jaibadonak/Joule_Observer34/DECISIONS.md

# Design Decisions

Every real decision gets an entry, written the day we make it. Takes two minutes and saves an argument in October.

The point of this file is the final interview. "Why did you choose X" gets asked, and this is how all four of us give the same answer about something we settled in August.

Anything still `OPEN` past its "needed by" date is a problem worth raising at standup.

---

## Worked example, delete once we have real ones

```
## DECIDED Shunt resistor value
Needed by:  before Lab 3, the differential amp gain depends on it
Owner:      Everyone
Decided:    0.5 ohm, made from two 1 ohm 0805 in parallel
Why:        Max current is 595 mA RMS at 7.5 VA and 12.6 V. Lab 1 caps shunt
            dissipation at 200 mW, and 0.5 ohm gives 177 mW. Splitting it
            across two 0805s puts 88 mW in each, inside the 125 mW package
            rating. Gives 421 mV peak to amplify.
Rejected:   1 ohm, better signal but 287 mW, over the lab limit and over the
            package rating even split two ways. Current transformer, no phase
            error correction needed but bigger, costlier and not in stock.
Date:       31/07/2026
```

---

# Analogue

## OPEN Shunt resistor value
Needed by:  before Lab 3, the differential amp gain depends on it
Owner:      Everyone
Decided:    0.5 ohm, made from two 1 ohm 0805 in parallel
Why:        Max current is 595 mA RMS at 7.5 VA and 12.6 V. Lab 1 caps shunt
            dissipation at 200 mW, and 0.5 ohm gives 177 mW. Splitting it
            across two 0805s puts 88 mW in each, inside the 125 mW package
            rating. Gives 421 mV peak to amplify.
Rejected:   1 ohm, better signal but 287 mW, over the lab limit and over the
            package rating even split two ways. Current transformer, no phase
            error correction needed but bigger, costlier and not in stock.
Date:       31/07/2026

## OPEN Voltage divider values
Needed by: week 4. Lab 1 Q4.1 targets 2 Vpk-pk at 15.4 Vrms.
Owner:

## OPEN Op-amp choice
Needed by: week 3. LT6221 confirmed usable for SMT pending stock. Rail to rail
but a dual not a quad, and higher supply current than the LM324. Option to mix.
Owner:

## OPEN Offset voltage
Needed by: week 4. Depends on the op-amp choice. 2.1 V is the as-taught answer
from LM324 headroom. Rail to rail lets us re-centre and use more ADC range.
Owner:

## OPEN ADC reference
Needed by: week 4. AVCC as taught, or an external LM4040. Only worth doing
together with the offset decision. Check the emulator amplitude first.
Owner:

## OPEN Anti-alias filter corner
Needed by: week 4. Lab says below 5 kHz. Alternating channels through one mux
makes the real per-channel Nyquist 2.4 kHz. Worth asking a TA.
Owner:

## OPEN First or second order filter
Needed by: before the analogue freeze, 1 Sep
Owner:

## OPEN Regulator: how the voltage drop gets shared
Needed by: week 4. Rin vs regulator dissipation, and whether the 78L05 survives
whatever current we end up drawing.
Owner:

## OPEN Zero-cross detector circuit
Needed by: before the analogue freeze. This is the one block the course leaves
entirely to us, so expect it to be probed hardest.
Owner:

# Firmware

## DECIDED Replace external mode LEDs with display suffixes
Needed by:  local display integration
Owner:      Team 34
Decided:    Remove ESP32 indicator GPIO setup/writes. Use the AVR's right-most
            digit (DS1) for U/A/P/E, leaving three digits for V/A/W/Wh.
            Adjust decimals automatically; UART current stays in mA and mode
            packets remain available as website metadata.
Why:        User requested a letter on the existing display instead of wiring
            four GPIO-driven LEDs. U is legible on seven segments; A uses amps
            so 400 mA is correctly labelled 0.40A.
Rejected:   Showing 400A for a 400 mA load; losing the suffix on overflow.
Date:       18/10/2026

## DECIDED Scope telemetry and calibration header
Needed by:  dashboard integration and scope comparison
Owner:      Team 34
Decided:    Send 32 contiguous V/I sample pairs at 104 us per point, AVR energy
            totals, and full-block raw ADC statistics over UART. Keep reference
            and channel gains in calibration.h, generated by the dashboard or
            edited directly. Rebuild/reflash AVR to apply; derive power scaling
            from both gains. Serve deterministic gzip HTML from ESP32 flash.
Why:        Actual captures expose distortion and flat/clipped channels. Raw
            RMS, DC and peak-to-peak support scope comparison without assuming
            a sine. One header avoids inconsistent power and waveform gains.
Rejected:   Synthetic live waveforms; gain calibration on a flat/clipped input;
            remote AVR writes without a receiver/bootloader protocol.
Date:       18/10/2026

## DECIDED Display digit order verified on hardware
Needed by:  display integration
Owner:      Team 34
Decided:    DS1 is the right-most digit, DS4 is the left-most. Scan logical
            least-significant digit first using DS1, DS2, DS3, DS4.
Why:        Bench readings were reversed: 400 appeared as 004 and 13.70 as
            073.1. Reversing digit enables also places the decimal correctly.
Rejected:   Reversing numeric strings or moving decimal bits separately.
Date:       18/10/2026

## DECIDED Single AVR project and ESP32 display indicators
Needed by:  hardware triage and final integration
Owner:      Team 34
Decided:    Retain the newer RMS-current implementation as
            Software/Joule_observer/Joule_observer.atsln (ATmega328PB, 2 MHz).
            Remove the duplicate Testing and placeholder UART AVR projects.
            USART0 sends $D,0..3 on display changes and every 250 ms.
            ESP32 LED1/2/3/4 use GPIO25/26/27/32 for V/I/P/E respectively.
            Keep UART2 RX on GPIO16; the schematic's RXD0 label was incorrect.
Why:        User requested one AVR project and mode LEDs driven by ESP32.
            The retained implementation removes each ADC channel's DC offset.
            Explicit mode messages follow the AVR scan instead of a second timer.
Rejected:   Independent ESP32 mode cycling, which drifts or resets out of sync.
Date:       18/10/2026

## OPEN Clock source
Needed by: week 3. Crystal or internal RC. Affects baud margin and the energy
time base.
Owner:

## OPEN Fixed point format
Needed by: week 4. Show the worst case headroom at 7.5 VA.
Owner:

## OPEN Sampling scheme and skew correction
Needed by: week 7. Channel order, how we realign, and how we handle the
residual.
Owner:

## OPEN How the display gets clocked
Needed by: week 3. Hardware SPI or bit bang, given USART1 overlaps SPI0 and the
ISP pins.
Owner:

## OPEN Programming interface
Needed by: week 3. ISP only or debugWIRE too. Constrains what hangs off RESET.
Owner:

# Board

## OPEN USB to serial bridge part
Needed by: week 3
Owner:

## OPEN BLE or WiFi
Needed by: week 3. Drives the power budget.
Owner:

## OPEN Altium workspace or local files
Needed by: week 3, before library work starts. Four of us drawing footprints
into files that cannot be merged is the thing to avoid.
Owner:

## OPEN Enclosure approach
Needed by: week 8
Owner:

# Project

## OPEN Are we doing the Smart Energy Challenge
Needed by: week 6, needs the course director's permission
Owner:
