jaibadonak/Joule_Observer34/L6 - Opamps.pdf

# ELECTENG 209

# Electronics System Design

## Signal Conditioning

Grant Covic and Duleepa Thrimawithana

# Learning Objectives

- Review of operational amplifier basics
- What are inverting and non-inverting amplifiers
- How are difference amplifiers created and why are they useful?
- Understanding practical signal conditioning circuits using single sided supplies
- What practical considerations are needed with voltage and current measurement circuits?
- How do we create RC filters and what are the design approaches in the frequency domain?
- Understanding the use and design of comparators for interrupt circuits
- Design guidelines for creating a regulated supply suited to your analogue and digital electronics.
Grant Covic and Duleepa Thrimawithana, Department of Electrical, Computer, and Software Engineering (2022) | 2

# The Energy Monitor Hardware design

- Requires Voltage Sensing, Current Sensing as discussed earlier.
- Signal conditioning
- Level shifting, amplification and noise reduction
- Generation of a suitable interrupt to trigger measurement from the microprocessor.
- Practical operation from a single 5V power regulator.

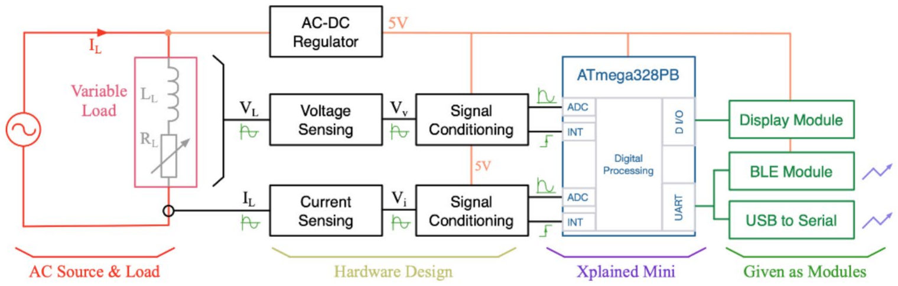
[picture p27: figure]

Grant Covic and Duleepa Thrimawithana, Department of Electrical, Computer, and Software Engineering (2022)

# Op-Amp Signal Conditioning

# Review of op-amps The inverting op-amp The non-inverting op-amp The difference amplifier Operation from a single sided supply Practical considerations with sensing voltage or current

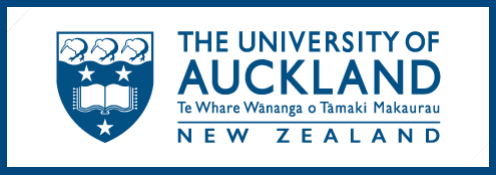
[picture p28: figure]

# The Op-Amp Equivalent Circuit

The op-amp equivalent circuit is shown in the figure below:

- Ideally RRiiii = ∞, rroo = 0, and the internal gain μμ = AA = ∞
- Input voltages vv1 and vv2 are independent
- The output voltage vvoo is ideally the amplification of vviiii = vv(+) − vv − , the voltage difference at the input terminals

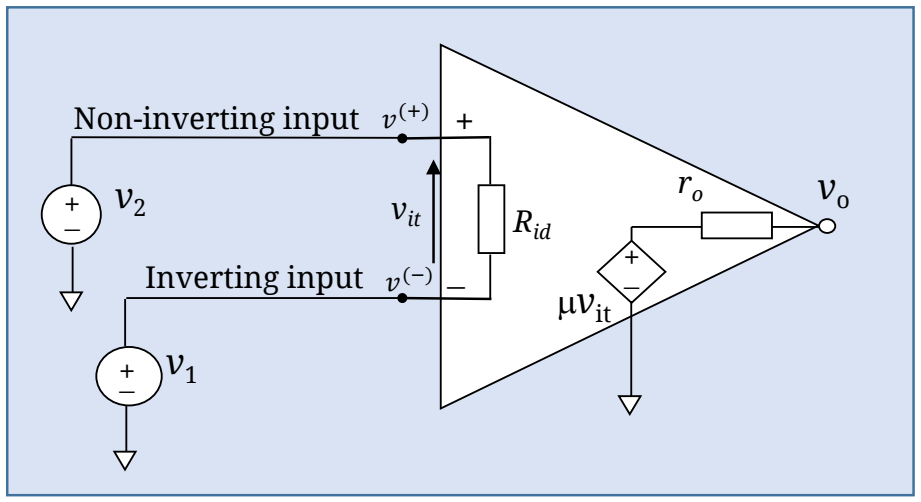
[picture p29: figure]
vit; µvit; Rid; Non-inverting input; Inverting input

# Virtual Earth Principle?

- In operation the output voltage is limited by the DC supplies of the op-amp.
- If the gain of the operational amplifier is very large the input terminals are kept at the same potential. This is a virtual short-circuit. Expressing this mathematically:

If AA = ∞, then the input voltage across the two terminals: vviiii = vv(+) − vv(−) = vvoo⁄AA = 0VV
- If the vv(+)

terminal is “grounded” to 0V , then this means the negative terminal vv(−) is a virtual earth.

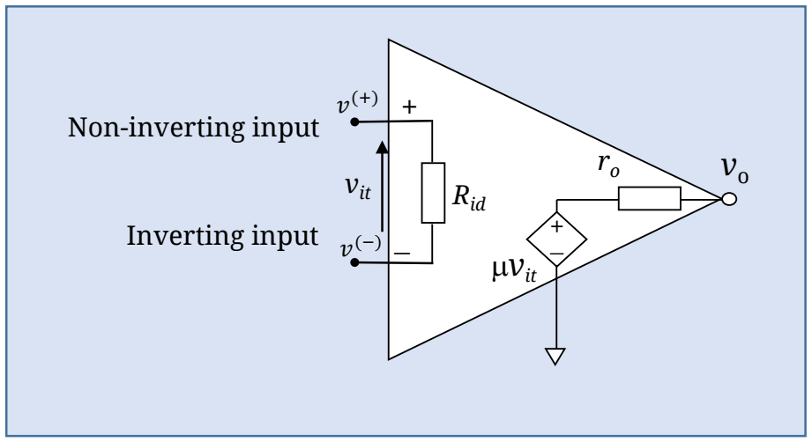
[picture p30: figure]
vo vit; µvit; Rid; Non-inverting input; Inverting input

# The Inverting Operational Amplifier

A circuit can be created with a single voltage input vvii and resistors RR1and RR2 around this op-amp as shown below.
- By grounding the positive input vv(+) = 0, because of the virtual earth (short circuit at the input) effectively vv(−) = 0
- To determine the gain, use Ohm’s and Kirchhoff’s voltage and current laws.

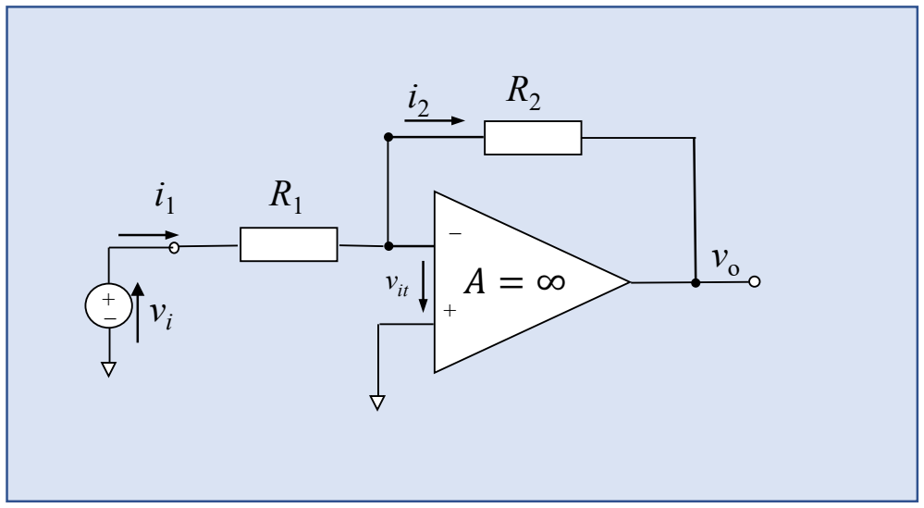
[picture p31: figure]
vit

# The Inverting Operational Amplifier

- A current ii1will flow because of input vvii
- Using Ohms law, given vv − = 0 by virtual earth:

# ii1 = vi − v ⁄ (−) RR1 = vi⁄RR1 ii2 = v ⁄ − − vo RR2 = −vo⁄RR2

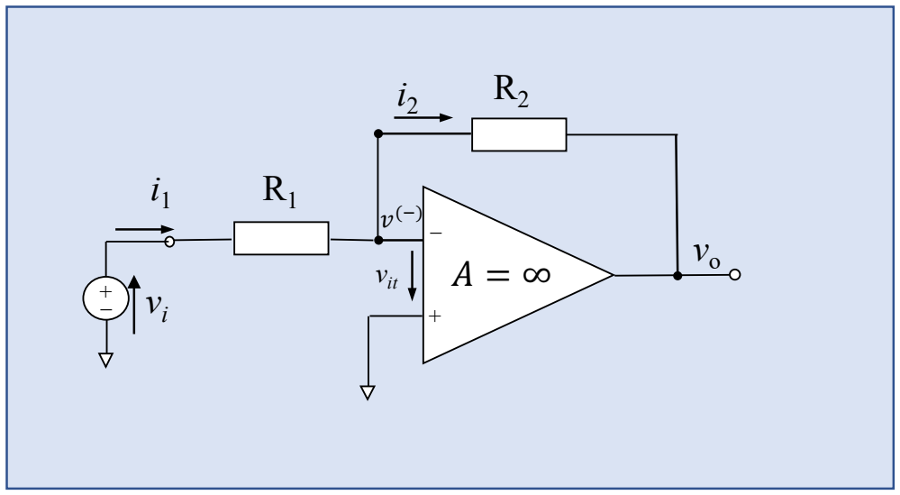
[picture p32: figure]
vit

# The Inverting Operational Amplifier

- Using Kirchhoff’s current law at a node ∑ ii = 0, evaluate the negative input terminal node
- Since ideally RRiiii = ∞ then no current will flow into the op-amp so: ii1 = ii2 ⇒
vvii
RR1

# = −vvoo

RR2
- Rearrange for the circuit voltage gain: GG = vvoo

vvii

= −RR2
RR1

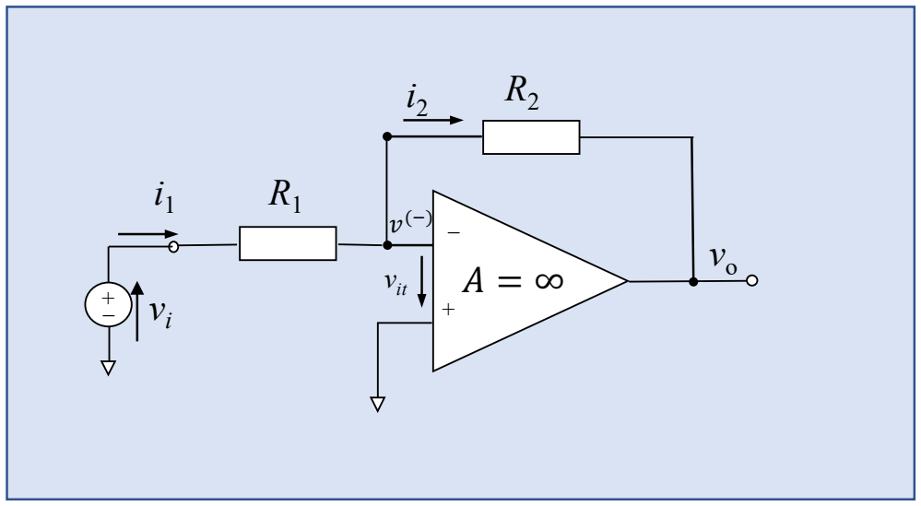
[picture p33: figure]
vit

# The Non-inverting Operational Amplifier

If the input is shifted to the positive terminal then a non-inverting configuration can be created as shown below:

- Following a similar analysis, with ideal infinite gain then vviiii = vv(+) − vv(−) = vvoo⁄AA = vvoo⁄∞ = 0

# - Then vv(−) = vv(+) = vvii

- Solve for the circuit gain again using Ohm’s and Kirchhoff’s laws.

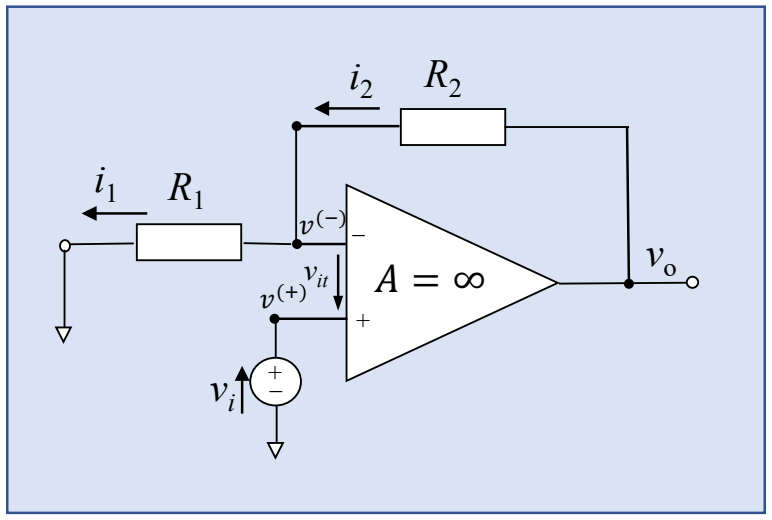
[picture p34: figure]
vit

# The Non-inverting Operational Amplifier

- Again the current into the op-amp at the negative terminal is zero because RRiiii = ∞
- So given ∑ ii = 0 then ii2 = ii1, where:

# ii1 = vv ⁄ (−) RR1 = VVii⁄RR1 ii2 = vv0 − vv ⁄ (−) RR2

- Equating the currents and rearranging for the voltage gain gives: GG ≡

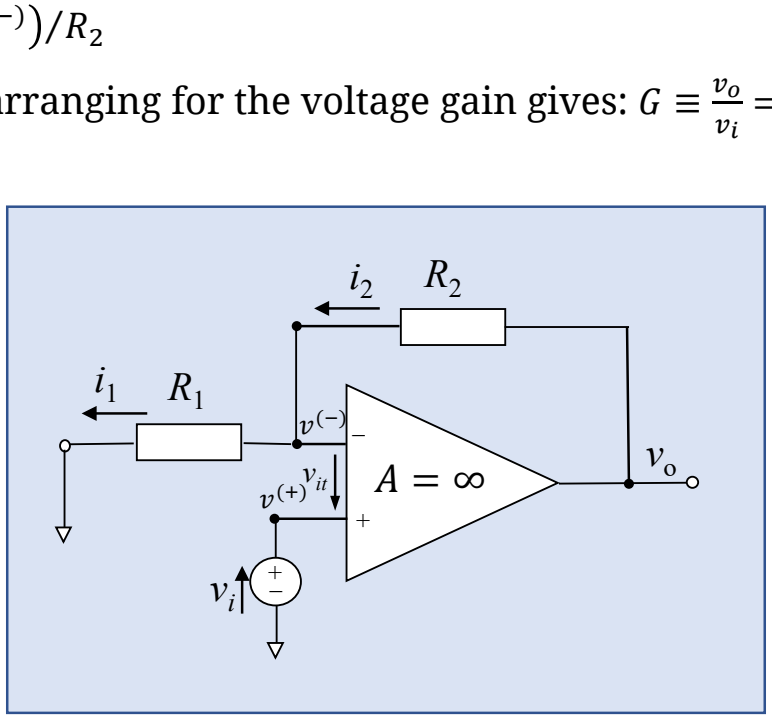
[picture p35: figure]
vo; vi; vit

= 1 + RR2
RR1

# Voltage Follower Example

- This is simply the non-inverting configuration where:

# RR1 = ∞Ω RR2 = 0Ω

- The gain of the circuit is therefore

GG ≡

vvoo

vvii

= 1 +

RR2
RR1

= 1

- The input impedance is the same as the op-amp, which is ideally infinite.
This means we don’t “load down” the input voltage (ideally draw zero current).

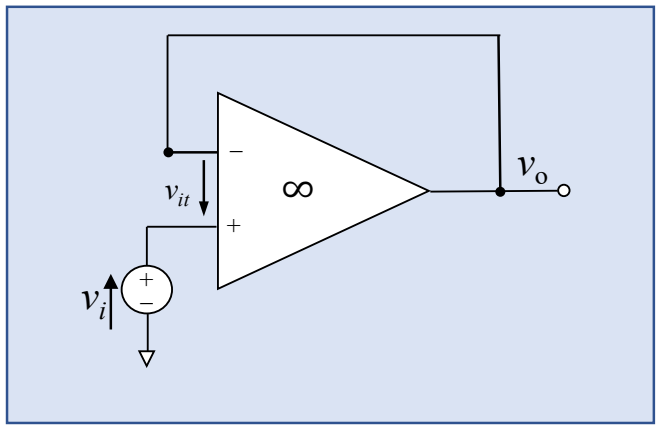
[picture p36: figure]
vit

# Common-mode and Difference Voltages

For circuits with two inputs, the input voltages can also be re-expressed in terms of a common (average) voltage component and a difference voltage.

- The common (average) voltage of both inputs is called the common mode voltage : vviiiiii = 1
2

# vv2 + vv1

- The difference voltage is simply : vviiii = vv2 − vv1

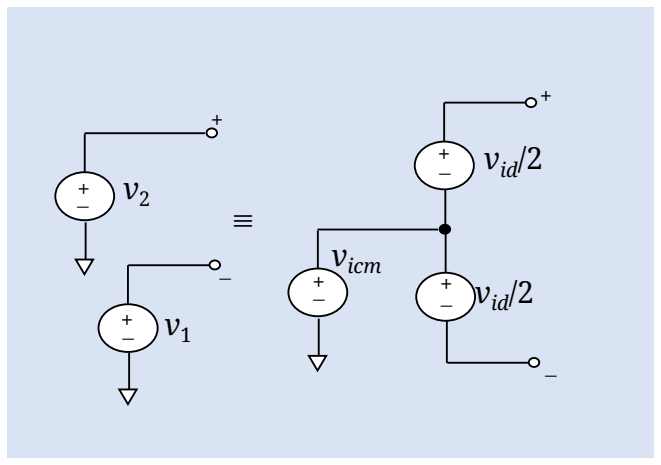
[picture p37: figure]
vicm; − vid/2; vid/2 ⁺

# The Single Op-Amp Difference Amplifier

Difference amplifiers (as shown below) are useful for measurement purposes in many electronic applications. While the op-amp is a difference amplifier of sorts, on its own the high gain makes it very sensitive to signal variations and non-linearities.
- Here the two input voltages are considered to be independent, and as such we can apply the principle of superposition to analyse the circuit.
- We assume AA = ∞ (so that vviiii = 0) and RRiiii = ∞ meaning that no current flows into the op-amp.

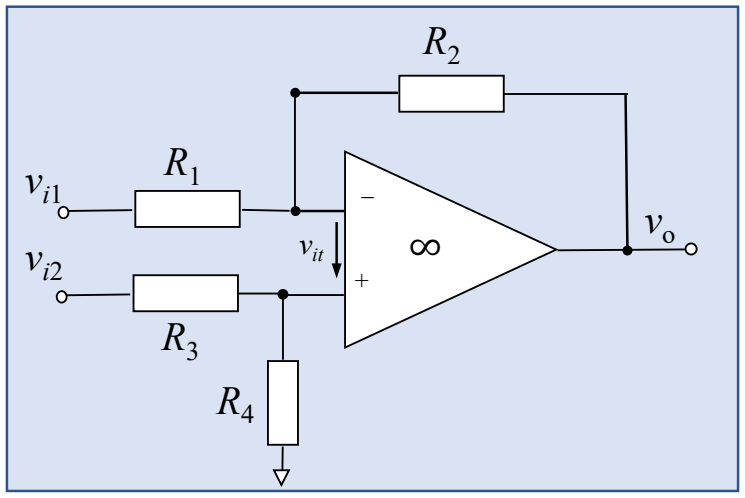
[picture p38: figure]
vit

# The Single Op-Amp Difference Amplifier

Reduce the second source to zero (shorting it to ground as shown) and determine the output voltage vvoo that results

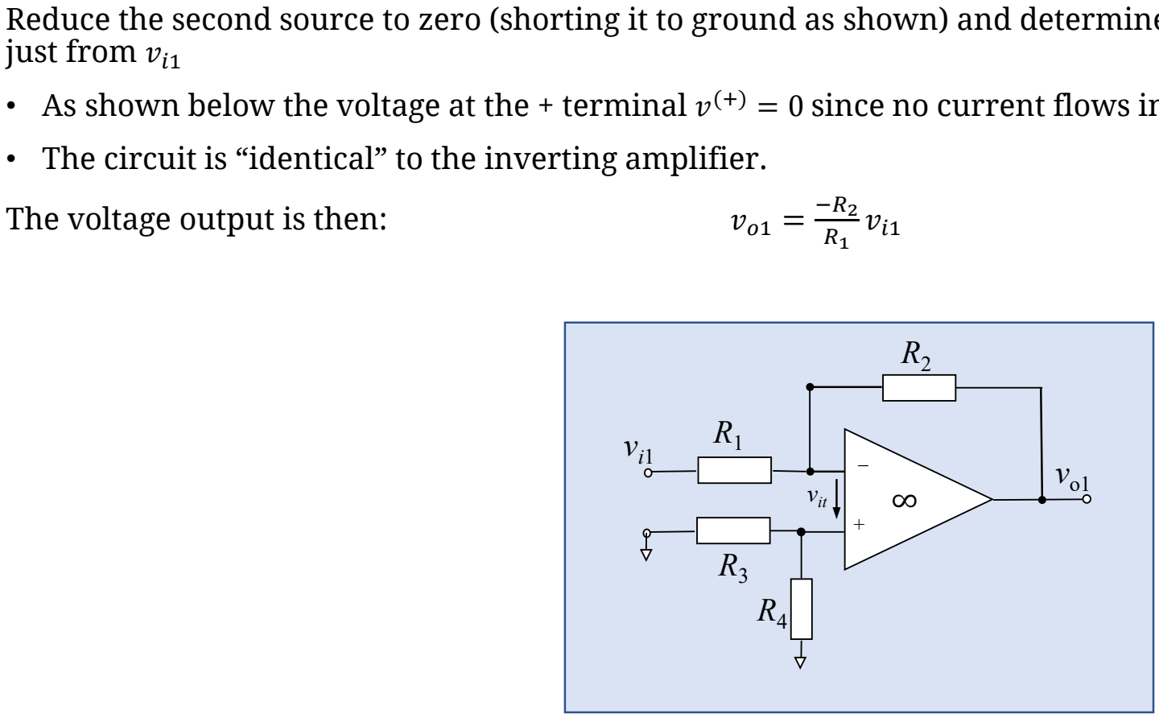
[picture p39: figure]
just from vvii; The voltage output is then:; vvoo = −RR2; vvii; vit

- As shown below the voltage at the + terminal vv(+) = 0 since no current flows into the op-amp at this terminal.
- The circuit is “identical” to the inverting amplifier.

# The Single Op-amp Difference Amplifier

- Reduce the first source to zero (shorting it to ground) and determine the output voltage vvoo that results just from vvii
- The voltage at the + terminal vv(+) can be determined by evaluating the current flow (noting no current flows into the op-amp at this terminal). This is essentially a voltage divider dependent on RR3and RR4.

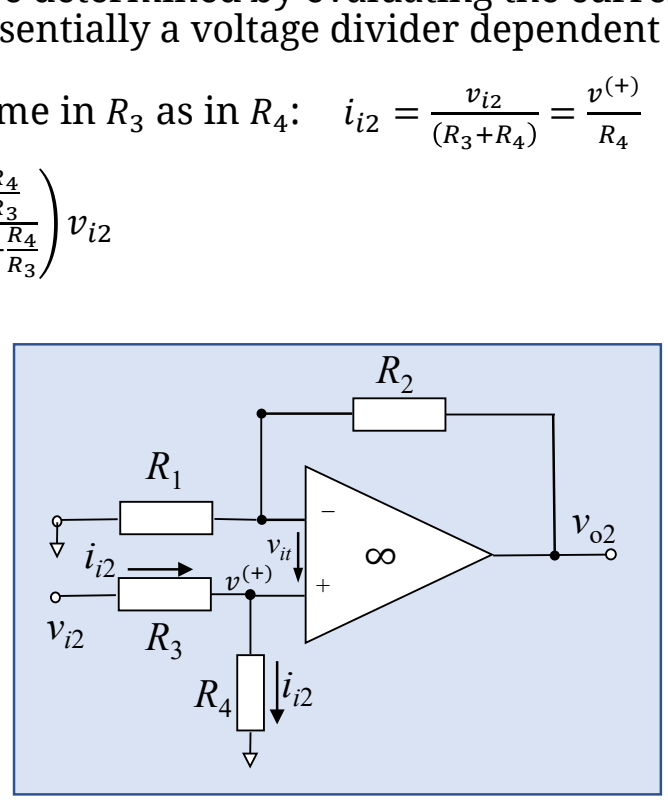
[picture p40: figure]
vvii; vit

- Thus the current iiii that flows is the same in RR3 as in RR4: iiii = vvii
Rewriting: | vv(+) = RR4

# RR3+RR4

# vvii =

RR4
RR3
1+RR4

# The Single Op-Amp Difference Amplifier

The circuit is identical the non-inverting amplifier, so that the voltage gain is:

# vvoo = 1 +

RR2
RR1

vv(+)

- Substituting in for vv(+) the voltage output is : vvoo = 1 + RR2
RR1

RR4
RR3
1+RR4
RR3

vvii

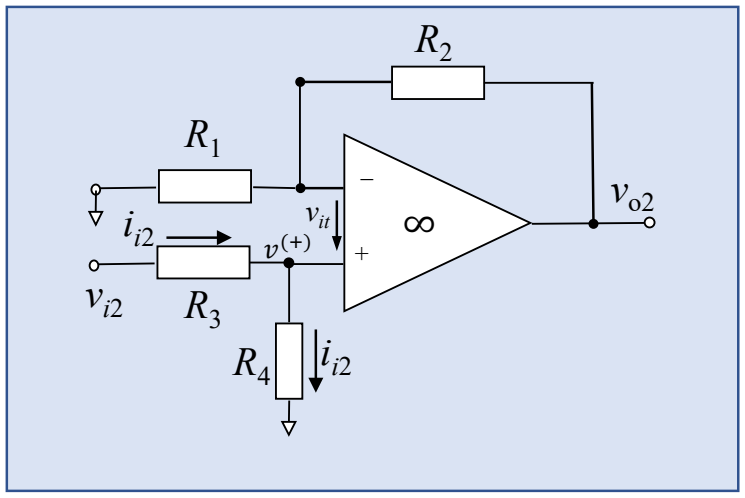
[picture p41: figure]
vit

# The Single Op-Amp Difference Amplifier

RR1

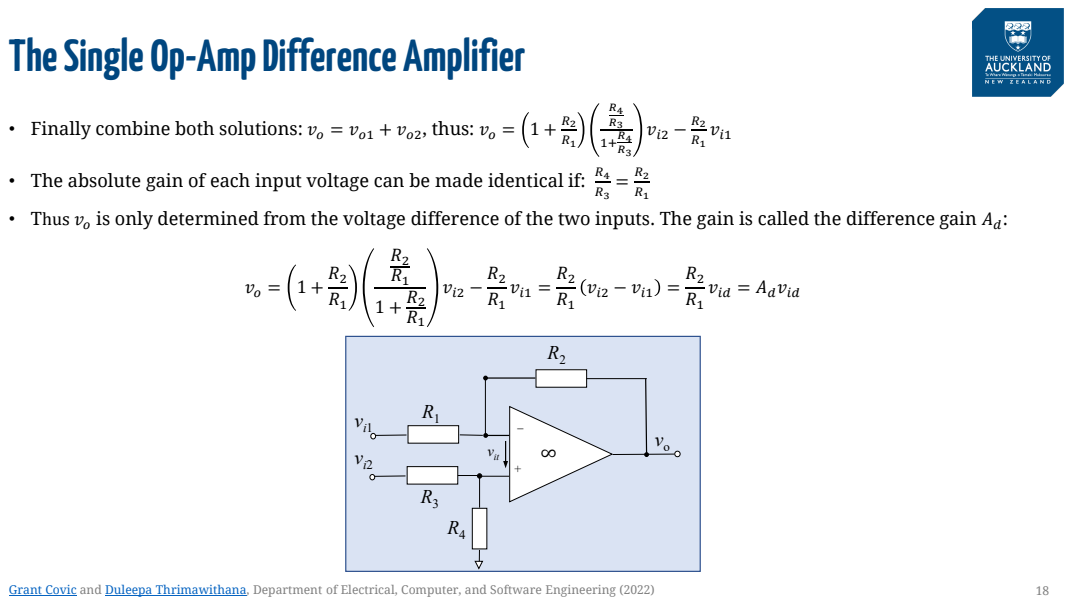
[picture p42: page 18]
vi − RR2 RR1; vi; vo = 1 +; vi = RR2 RR1; vi − vi = RR2 RR1; vii = A vii; vit

• Finally combine both solutions: vvoo = vvoo + vvoo , thus: vvoo = 1 + RR2

• The absolute gain of each input voltage can be made identical if: RR4
• Thus vvoo is only determined from the voltage difference of the two inputs. The gain is called the difference gain AA :

# Does the Difference Amplifier have a Common Mode Gain ?

To find out, we assume both inputs are driven by the same (common) voltage, and determine the gain.

- Because the op-amp is ideal: vv(−) = vv(+)
- Determine vv(+) from the input voltage as: vv(+) = RR4

# RR3+RR4

## vviiiiii

- Now calculate current ii flowing in RR1and RR2using Ohms Law

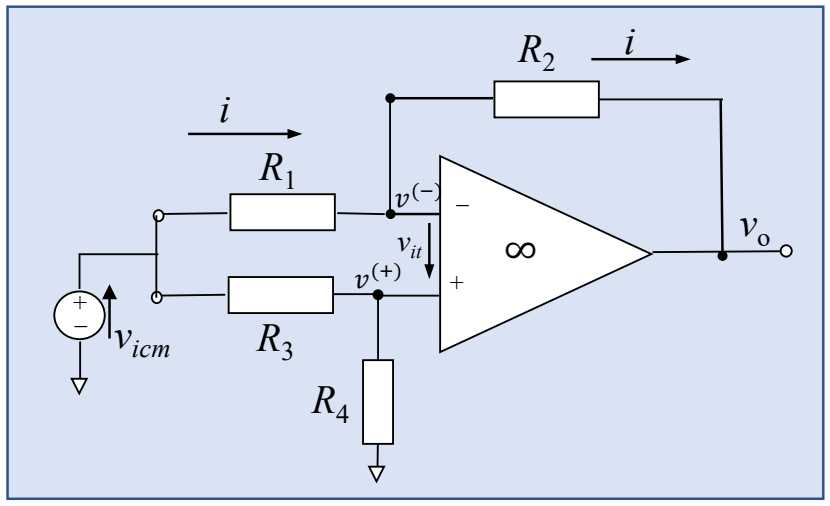
[picture p43: figure]
vit; vicm

# Does the Difference Amplifier have a Common Mode Gain ?

Current through RR1:

# ii = vviiiiii − vv(−)

RR1

=

# vviiiiii 1 − RR4

# RR3 + RR4

RR1

# = vviiiiii

RR1

RR3

# RR3 + RR4

Current through RR2:

# ii = vv(−) − vvoo

RR2

=

## vviiiiii

RR4

# RR3 + RR4 − vvoo

RR2

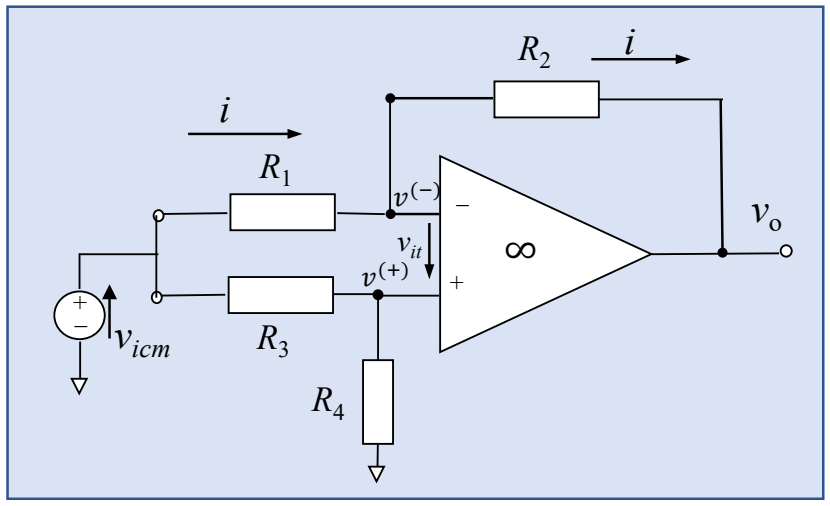
[picture p44: figure]
vit; vicm

# Does the Difference Amplifier have a Common Mode Gain ?

1

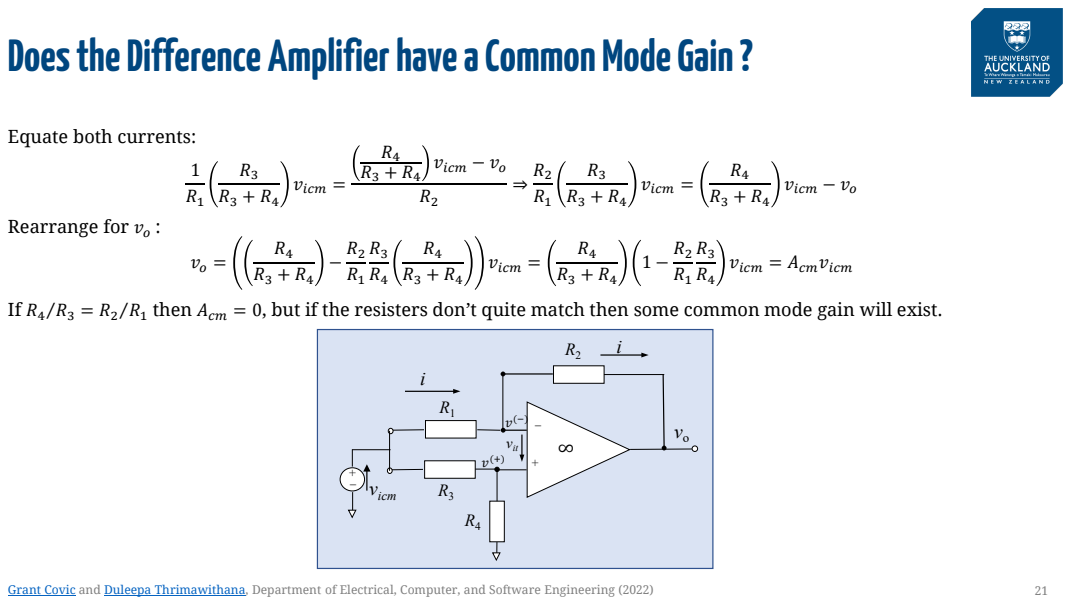
[picture p45: page 21]
viii =; viii − vo RR2; viii = RR4 RR3 + RR4; viii − vo; vo = RR4 RR3 + RR4; viii = A viii; vit; vicm

Equate both currents:

Rearrange for vvoo :

If RR4⁄RR3 = RR2⁄RR1 then AA = 0, but if the resisters don’t quite match then some common mode gain will exist.
