jaibadonak/Joule_Observer34/Joule_Observer_Calibration.xlsx

Sheet: Setup
Joule Observer: calibration workbook
Compare device display and website against the oscilloscope, then against theory. Team 34, ELECTENG 209.
HOW TO USE
1. Yellow cells with blue text are inputs. Grey cells are formulas, do not overwrite them.
2. Set the load, then fill one row per test on 'Calibration Log'. Row 7 is an EXAMPLE: overwrite it.
3. Scope: Vrms of the source, Vrms across the shunt (mV), and the V-to-I time delay (us, positive = current lags).
4. Display and website columns: type what you read. Website shows V (2 dp), I (mA), P in W (2 dp). It has no energy field.
5. 'Summary' gives average and worst-case error per comparison and recommended new scale constants for calcs.h.
6. 'Energy' is a separate timed test (display energy is whole mWh, so run long enough).
Measurement constants
Item | Value | Unit | Source / note
Shunt resistance | 0.5 | ohm | analogue/MASTER_SCHEMATIC_EE209.asc, 0.5 ohm shunt (calcs.h). Measure the real one with a meter and overwrite.
Nominal frequency | 500 | Hz | README spec: 14 Vrms, 500 Hz
Accuracy spec | 5 | % of full scale | README spec table: +/-5% of full scale
Full scale Vrms | 15.4 | V | ASSUMPTION: 14 V +10% (README source tolerance). Change if the team defines it differently.
Full scale Irms | 595 | mA | ASSUMPTION: 7.5 VA / 12.6 V (largest load at lowest source voltage).
Full scale power | 7500 | mW | ASSUMPTION: 7.5 VA upper load limit, rounded.
Display vs website tolerance, V | 0.01 | V | Website shows 2 dp, so 0.01 V is rounding only.
Display vs website tolerance, I | 1 | mA | Website shows whole mA.
Display vs website tolerance, P | 10 | mW | Website shows W to 2 dp, so 10 mW is rounding only.
Firmware constants (copy from calcs.h / what is flashed)
Constant | Value | Unit | Meaning
ADC_OFFSET_COUNTS | 422 | counts | Bias level subtracted from each sample (2.0625 V / 5 V x 1024)
V_MV_PER_COUNT_X100 | 10926 | x100 mV/count | 109.26 mV of source voltage per ADC count
I_MA_PER_COUNT_X1000 | 3877 | x1000 mA/count | 3.877 mA of load current per ADC count
P_MW_PER_COUNT2_X10000 | 4236 | x10000 mW/count^2 | 0.4236 mW per count x count
ADC and front-end check
Item | Value | Unit | Source / note
Measured AVCC (ADC reference) | 5 | V | Measure on the board with a meter. 5.000 is the nominal placeholder.
Measured bias node (VREF) at ADC pin, no signal | 2.0625 | V | Measure at PC0/PC1 with the source off. 2.0625 is the LTspice value, so overwrite it.
Voltage channel gain | 0.04469 | V/V | From calcs.h comment (divider x difference amp). Check against the LTspice model.
Current channel gain | 1.2593 | mV per mA | From calcs.h comment (0.5 ohm x 2.5185).
ADC step (1 LSB) | 4.8828 | mV | AVCC / 1024
Bias level in counts (measured) | 422.4 | counts | Compare with ADC_OFFSET_COUNTS
Recommended ADC_OFFSET_COUNTS | 422 | counts | Use this if it differs from the flashed value
Theoretical voltage scale | 109.2596 | mV/count | LSB / V gain
Theoretical current scale | 3.8774 | mA/count | LSB / I gain
Theoretical power scale | 0.4236 | mW/count^2 | mV x mA / 1000
Firmware voltage scale | 109.2600 | mV/count
Firmware current scale | 3.8770 | mA/count
Firmware power scale | 0.4236 | mW/count^2
Firmware vs theory, voltage | 0.000346112% | % | Non-zero = AVCC or gain differs from the assumption
Firmware vs theory, current | -0.010371072% | %
Firmware vs theory, power | -0.01026576438% | %

Sheet: Calibration Log
Calibration log: display / website vs oscilloscope vs theory
One row per test. Errors are (measured - reference) / reference. Pass/fail is on % of full scale (Setup B16). Row 7 is an example.
THEORY INPUTS |  |  |  |  |  |  |  | OSCILLOSCOPE |  |  |  |  | DEVICE DISPLAY |  |  | WEBSITE |  |  | THEORY (calculated) |  |  | SCOPE (calculated) |  |  |  | ERROR vs SCOPE and THEORY (%) |  |  |  |  |  |  |  |  |  |  |  |  |  |  | CHECKS |  | CORRECTION RATIOS
Test # | Load setting / notes | DC Input | Source Vrms (V) | measurement across load | Resistor value | Load S (VA) | Nominal PF | Scope Vrms (V) | Scope shunt Vrms (mV) | V-I SCOPE-PHASE | Scope V-I delay (us) | Scope freq (Hz) | Display Vrms (V) | Display Irms (mA) | Display P (mW) | Website Vrms (V) | Website Irms (mA) | Website P (W) | Theory Vrms (V) | Theory Irms (mA) | Theory P (mW) | Scope Irms (mA) | Scope phase (deg) | Scope PF | Scope P (mW) | Disp vs Scope: V | Disp vs Scope: I | Disp vs Scope: P | Disp vs Theory: V | Disp vs Theory: I | Disp vs Theory: P | Web vs Scope: V | Web vs Scope: I | Web vs Scope: P | Web vs Theory: V | Web vs Theory: I | Web vs Theory: P | Scope vs Theory: V | Scope vs Theory: I | Scope vs Theory: P | Display = Website? | Display vs Scope (% FS spec) | Ratio Scope/Disp: V | Ratio Scope/Disp: I | Ratio Scope/Disp: P
1 | EXAMPLE: 5 VA, PF 0.8. Overwrite |  | 14.000 |  |  | 5.00 | 0.800 | 14.020 | 178.6 |  |  | 500.0 | 14.060 | 351.0 | 3950.0 | 14.060 | 351.0 | 3.95 | 14.000 | 357.1 | 4000.0 | 357.2 |  |  |  | 0.3% | -1.7% |  | 0.4% | -1.7% | -1.2% | 0.3% | -1.7% |  | 0.4% | -1.7% | -1.2% | 0.1% | 0.016% |  | OK |  | 0.997 | 1.018
2 |  | 20V | 12.460 | 12.330 |  | 7.50 |  | 12.477 | 244.6 | 36.6 | 203.6 | 500.0 | 12.700 | 490.0 | 5.3 | 12.660 | 491.0 | 5.48 | 12.460 | 601.9 |  | 489.2 | 36.6 | 0.802 | 4897.7 | 1.8% | 0.2% | -99.9% | 1.9% | -18.6% |  | 1.5% | 0.4% | 11.9% | 1.6% | -18.4% |  | 0.1% | -18.7% |  | CHECK | FAIL | 0.982 | 0.998 | 920.612
3 |  | 21V | 12.660 | 12.437 |  | 7.50 |  | 12.679 | 497.7 |  |  | 501.6 | 12.800 |  |  | 12.820 |  |  | 12.660 | 592.4 |  | 995.4 |  |  |  | 1.0% |  |  | 1.1% |  |  | 1.1% |  |  | 1.3% |  |  | 0.2% | 68.0% |  |  |  | 0.991
4 |  | 22V | 12.780 | 12.580 |  | 7.50 |  | 12.849 | 506.3 |  |  | 501.0 | 12.900 |  |  | 12.950 |  |  | 12.780 | 586.9 |  | 1012.6 |  |  |  | 0.4% |  |  | 0.9% |  |  | 0.8% |  |  | 1.3% |  |  | 0.5% | 72.5% |  |  |  | 0.996
5 |  | 23V | 12.903 | 12.680 |  | 7.50 |  | 12.950 | 518.7 |  |  | 501.0 | 13.100 |  |  | 13.090 |  |  | 12.903 | 581.3 |  | 1037.4 |  |  |  | 1.2% |  |  | 1.5% |  |  | 1.1% |  |  | 1.4% |  |  | 0.4% | 78.5% |  |  |  | 0.989
6 |  | 26V |  |  |  | 7.50
7 |  | 29V |  |  |  | 7.50
8 |  | 32V |  |  |  | 7.50
9 |  |  |  |  |  | 7.50
10
11 |  | 20V | 12.959 | 12.898 |  | 2.50 |  | 13.000 | 67.0 |  |  | 501.0 | 13.100 |  |  | 13.140 |  |  | 12.959 | 192.9 |  | 134.0 |  |  |  | 0.8% |  |  | 1.1% |  |  | 1.1% |  |  | 1.4% |  |  | 0.3% | -30.6% |  |  |  | 0.992
12 |  | 21V | 13.108 | 13.045 |  | 2.50 |  | 13.150 | 67.8 |  |  | 501.0 | 13.300 |  |  | 13.290 |  |  | 13.108 | 190.7 |  | 135.5 |  |  |  | 1.1% |  |  | 1.5% |  |  | 1.1% |  |  | 1.4% |  |  | 0.3% | -29.0% |  |  |  | 0.989
13 |  | 22V | 13.225 | 13.156 |  | 2.50 |  | 13.270 | 68.3 |  |  | 501.0 | 13.400 |  |  | 13.410 |  |  | 13.225 | 189.0 |  | 136.6 |  |  |  | 1.0% |  |  | 1.3% |  |  | 1.1% |  |  | 1.4% |  |  | 0.3% | -27.7% |  |  |  | 0.990
14 |  | 23V | 13.332 | 13.269 |  | 2.50 |  | 13.350 | 68.8 |  |  | 501.0 | 13.500 |  |  | 13.530 |  |  | 13.332 | 187.5 |  | 137.6 |  |  |  | 1.1% |  |  | 1.3% |  |  | 1.3% |  |  | 1.5% |  |  | 0.1% | -26.6% |  |  |  | 0.989
15 |  | 26V | 13.580 | 13.518 |  | 2.50 |  | 13.630 | 70.2 |  |  | 501.0 | 13.800 |  |  | 13.790 |  |  | 13.580 | 184.1 |  | 140.5 |  |  |  | 1.2% |  |  | 1.6% |  |  | 1.2% |  |  | 1.5% |  |  | 0.4% | -23.7% |  |  |  | 0.988
16 |  | 29V | 13.760 | 13.690 |  | 2.50 |  | 13.810 | 71.2 |  |  | 502.0 | 14.000 |  |  | 13.970 |  |  | 13.760 | 181.7 |  | 142.4 |  |  |  | 1.4% |  |  | 1.7% |  |  | 1.2% |  |  | 1.5% |  |  | 0.4% | -21.6% |  |  |  | 0.986
17 |  | 32V | 13.877 | 13.820 |  | 2.50 |  | 13.930 | 71.8 |  |  | 501.0 | 14.100 |  |  | 14.090 |  |  | 13.877 | 180.2 |  | 143.6 |  |  |  | 1.2% |  |  | 1.6% |  |  | 1.1% |  |  | 1.5% |  |  | 0.4% | -20.3% |  |  |  | 0.988
18
19
20
 |  |  |  |  |  | RL |  |  |  |  |  |  |  | Ipeak
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
 | Load 5 | 32V |  |  |  | 0.00 |  |  |  |  | 0.0
 | Load 6 | 20V |  |  |  | 0.00 |  |  |  |  | 0.0
 | Load 6 | 26V |  |  |  | 0.00 |  |  |  |  | 0.0
 | Load 6 | 32V |  |  |  |  |  |  |  |  | 0.0
 | Load 7 |  |  |  |  |  |  |  |  |  | 0.0
 | Load 7 |  |  |  |  |  |  |  |  |  | 0.0

Sheet: Energy
Energy test: display energy change over a timed run
Hold a steady load, note display energy, wait, note again. Display energy is whole mWh, so allow +/-1 mWh of quantisation. The website has no energy field. Row 6 is an example.
Test # | Load setting / notes | Power (mW) (scope or Log) | Interval (s) | Display energy start (mWh) | Display energy end (mWh) | Theory dE (mWh) | Display dE (mWh) | Error (%) | Quantisation +/-1 mWh (% of theory) | Result
1 | EXAMPLE: 4 W for 10 min. Overwrite | 4000 | 600 | 120 | 780 | 666.7 | 660 | -1.0% | 0.1% | PASS
2
3
4
5
6
7
8
9
10
Result rule (assumption): pass if |display dE - theory dE| <= 1 mWh + spec % x theory dE. Spec % is Setup B16.

Sheet: Summary
Summary
Average and worst-case error across the filled-in rows of 'Calibration Log'. Blank until you enter data.
Error by comparison
Comparison | Quantity | Average error | Worst |error| | Rows used
Display vs Scope | Vrms | 1.0% | 1.8% | 12
Display vs Scope | Irms | -0.8% | 1.7% | 2
Display vs Scope | Power | -99.9% | 99.9% | 1
Display vs Theory | Vrms | 1.3% | 1.9% | 12
Display vs Theory | Irms | -10.2% | 18.6% | 2
Display vs Theory | Power | -1.2% | 1.2% | 1
Website vs Scope | Vrms | 1.1% | 1.5% | 12
Website vs Scope | Irms | -0.7% | 1.7% | 2
Website vs Scope | Power | 11.9% | 11.9% | 1
Website vs Theory | Vrms | 1.4% | 1.6% | 12
Website vs Theory | Irms | -10.1% | 18.4% | 2
Website vs Theory | Power | -1.2% | 1.2% | 1
Scope vs Theory | Vrms | 0.3% | 0.5% | 12
Scope vs Theory | Irms | 1.7% | 78.5% | 12
Scope vs Theory | Power | n/a | n/a | 0
Display vs Scope, pass/fail (% of full scale)
PASS rows |  | 0
FAIL rows |  | 1
Display / website mismatches (CHECK) |  | 1
Recommended scale constants for calcs.h (average of Scope / Display)
Constant | Flashed value | Avg correction ratio | Recommended value | Rows used
V_MV_PER_COUNT_X100 | 10926 | 0.9898 | 10814 | 12
I_MA_PER_COUNT_X1000 | 3877 | 1.0080 | 3908 | 2
P_MW_PER_COUNT2_X10000 | 4236 | 920.6117 | 3899711 | 1
Offset: recommended ADC_OFFSET_COUNTS (from measured bias, Setup) |  |  | 422
Check: V ratio x I ratio vs P ratio |  | 0.001 | V x I does not explain P: suspect V/I sample skew or phase
Ratio = scope reading / display reading. Fix V and I first, then re-check P. Apply new constants, reflash, then repeat the tests.
