jaibadonak/Joule_Observer34/FinalParentSchematic.asc

C1: cap; 220µF
C2: cap; 0.1µF
C3: cap; 10nF
D1: diode; 1N4148
L_Load: ind; 4mH; Rser=1m
R1: res; 1.17
R2: res; 470
R3: res; 13.7k
R4: res; 10k
R_Load: res; 16.3
R_Shunt: res; 0.5
RA: res; 100k
RB: res; 4.7k
U1: ZeroCrossing
U2: ZeroCrossing
U3: LT1085-5
U4: opamp2; LM324
V1: voltage; SINE(0 {15.4*sqrt(2)} 500); AC 1 0
V2: voltage; 5
V3: voltage; 2.1
X1: sig_cond-2ord
X2: sig_cond_2ord_shunt
Named nets: 0, Vsource, V_node, I_node, 5V_DC, 2p1_DC, 5V_Source, 2p1V_Source
------------------------------------------
--------------------------------------------------------------------------
Voltage Sensing
Current Sensing
.tran 0 100ms 0s 0.1ms
.lib LM324.lib
.ac dec 30 1 1MEG
Source Voltages
5V Regulator
2.1V DC offset
