jaibadonak/Joule_Observer34/analogue/MASTER_SCHEMATIC_EE209.asc

CIFB: cap; 20n
CISH: cap; 10n
CO1: cap; 220µ
CO: cap; 10µ
COHF: cap; 100n
CREF1: cap; 10µ
CREF2: cap; 100n
CVFB: cap; 680p
CVSH: cap; 330p
DREG: diode; 1N4148
LLOAD: ind; 4m
R5LOAD: res; 100
RI1N: res; 27k
RI1P: res; 27k
RI2FB: res; 68k
RI2REF: res; 68k
RIF1: res; 6.8k
RIF2: res; 6.8k
RIN: res; 15
RLOAD1: res; {RLOAD}
RREF_BOT: res; 3.3k
RREF_TOP: res; 4.7k
RSHUNT1: res; 1
RSHUNT: res; 1
RV1A: res; 5.6k
RV1B: res; 10k
RV2FB: res; 10k
RV2REF: res; 10k
RVA: res; 100k
RVB: res; 4.7k
RVF1: res; 33k
RVF2: res; 33k
U1: LT1085-5
UI_COND: opamp2; LM324
UI_FILT: opamp2; LM324
UREF: opamp2; LM324
UV_COND: opamp2; LM324
UV_FILT: opamp2; LM324
UZC1: opamp2; LM324
UZC: opamp2; LM324
V5TEST: voltage; 5
VAC1: voltage; SINE(0 {VRMS*sqrt(2)} {FREQ}); AC 1 0
Named nets: VAC, 0, SHUNT_TOP, VVS, VREF, V5, V_OUT, VZC, I_OUT, V_ADC, I_ADC, IZC
ELECTENG 209 - ANALOGUE ENERGY MONITOR
Edit VRMS, FREQ and RLOAD below for testing
.param VRMS=12.6 FREQ=500 RLOAD=93.6
.tran 0 0.025 0 50u
.options plotwinsize=0
BLOCK A - AC SOURCE, LOAD, CURRENT SHUNT AND VOLTAGE DIVIDER
RSHUNT = 0.5 ohm; voltage divider = 100k/4.7k. SHUNT_TOP is Vis.
BLOCK B - CURRENT DIFFERENTIAL AMPLIFIER / LEVEL SHIFT
I_OUT = VREF + (22k/10k)*Vshunt ~ VREF + 2.2*Vshunt
BLOCK C - VOLTAGE DIFFERENTIAL AMPLIFIER / LEVEL SHIFT
5.6k compensates the 100k||4.7k divider Thevenin resistance.
BLOCK D - CURRENT 2nd ORDER BUTTERWORTH LPF (~1.65 kHz)
CIFB is the Sallen-Key feedback capacitor; CISH is the shunt capacitor.
BLOCK E - VOLTAGE 2nd ORDER BUTTERWORTH LPF (~1.65 kHz)
Voltage and current filters are identical so relative phase error largely cancels.
BLOCK F - HALF-WAVE RECTIFIER + 5 V REGULATOR
Connect Vac ONLY FOR TRANSIENT ANALYSIS
BLOCK G - CLEAN 2.1 V OFFSET REFERENCE
VREF ~ 5*3.3/(4.7+3.3) = 2.0625 V. Buffer prevents loading by both differential amplifiers.
BLOCK H - VOLTAGE ZERO-CROSS DETECTOR
Comparator switches when V_OUT = VREF, which corresponds to VAC = 0.
Using unfiltered V_OUT here so the anti-alias filter's ~25 degree phase delay is not added.
Verification parameter sets:
7.5 VA @12.6 V: RLOAD~16.53 ohm
7.5 VA @15.4 V: RLOAD~28.52 ohm
2.5 VA @15.4 V: RLOAD~93.53 ohm
Frequency limits: 490 Hz and 510 Hz
.lib LM324.lib
.ac dec 30 1 100kHz
BLOCK H - VOLTAGE ZERO-CROSS DETECTOR
Comparator switches when V_OUT = VREF, which corresponds to VAC = 0.
Using unfiltered V_OUT here so the anti-alias filter's ~25 degree phase delay is not added.
