jaibadonak/Joule_Observer34/LTspice-Final/ZeroCrossing.asc

R1: res; 220k
R2: res; 2.2k
U1: opamp2; LM324
Named nets: Vref, Vsignal, 0, VCCP, Vcross
.lib LM324.lib
