jaibadonak/Joule_Observer34/LTspice-Final/sig_cond-2ord.asc

Cf: cap; 15nF
Cp: cap; 15nF
R1A: res; 5.6K
R1B: res; 10K
R2: res; 10K
R2v1: res; 10k
R4: res; 10k
U1: opamp2; LM324
Named nets: Vf, Vvs, V-shift, Vccp, 0
