jaibadonak/Joule_Observer34/LTspice-Final/sig_cond.asc

C1: cap; 4.9nF
R1v1: res; 5.6K
R1v1c: res; 3.3K
R2: res; 10K
R2v1: res; 10k
R4v1: res; 10k
U1: opamp2; LM324
Named nets: 0, Vf, Vvs, V-shift, Vcc+
