jaibadonak/Joule_Observer34/LTspice-Final/sig_cond_2ord_shunt.asc

Cf: cap; 820pF
Cp: cap; 820pF
R1: res; 100k
R2: res; 220k
R3: res; 100k
R4: res; 220k
Ri: res; 270K
U1: opamp2; LM324
Named nets: V-Shift, Vis, 0, VCCP, Vis_f
