jaibadonak/Joule_Observer34/LTspice-Final/sig_cond_shunt.asc

C1: cap; 27nF
R1: res; 100k
R2: res; 220k
R3: res; 100k
R4: res; 220k
R5: res; 3.9K
U1: opamp2; LM324
Named nets: V-Shift, Vis, 0, VCCP, Vis_f
