jaibadonak/Joule_Observer34/(list of files, drawings)

Other design files:
firmware/UART_SIM.pdsprj
Software/Proteus/Overall_Project_Proteus.pdsprj
Software/Proteus/Project Backups/Overall_Project_Proteus [20261017, 18-52-34].pdsprj
