jaibadonak/Joule_Observer34/Software/Joule_observer/Joule_observer/common.h

/*
 * common.h
 *
 * Created: 14/10/2026 5:08:29 pm
 *  Author: Admin
 */ 


#ifndef COMMON_H_
#define COMMON_H_

#include "adc.h"
#include "calcs.h"
#include "display.h"

//---------------------------- ADC ----------------------------//
/*extern volatile uint16_t v_samples[samples];
extern volatile uint16_t i_samples[samples];
extern volatile uint8_t  channel;
extern volatile uint16_t sample_position ;
extern volatile uint8_t flush; //a variable to ensure we are starting fresh conversions

extern volatile uint16_t *vOrI_samples ; */
//---------------------------- ____ ----------------------------//

#endif /* COMMON_H_ */
