jaibadonak/Joule_Observer34/(commit log)

2026-08-25 Goated commit 🔥
2026-08-26 Adding initial UART code
    [UART_SIM.pdsprj]
2026-08-26 Refactor UART_209 main.c for variable updates and functions
2026-08-26 Small filter changes
2026-10-15 doing some adc stuff.
2026-10-16 Add UART driver implementation
2026-10-16 change uart.c comments
2026-10-20 Enhance calibration.h with detailed comments
    Added comments for calibration gain explanation and notes.
2026-10-20 Refactor ADC capture logic and enhance comments
    Refactor ADC handling logic and improve comments for clarity.
2026-10-20 Refactor ADC processing functions for clarity
    Refactor ADC processing functions to improve clarity and maintainability. Introduce whole_cycle_range and window_mean_x100 for better cycle handling and averaging.
2026-10-21 Add comments for uart_int32 function
    Added comments to explain the uart_int32 function and its purpose.
